dougmany/handplow/img/cutaway.png

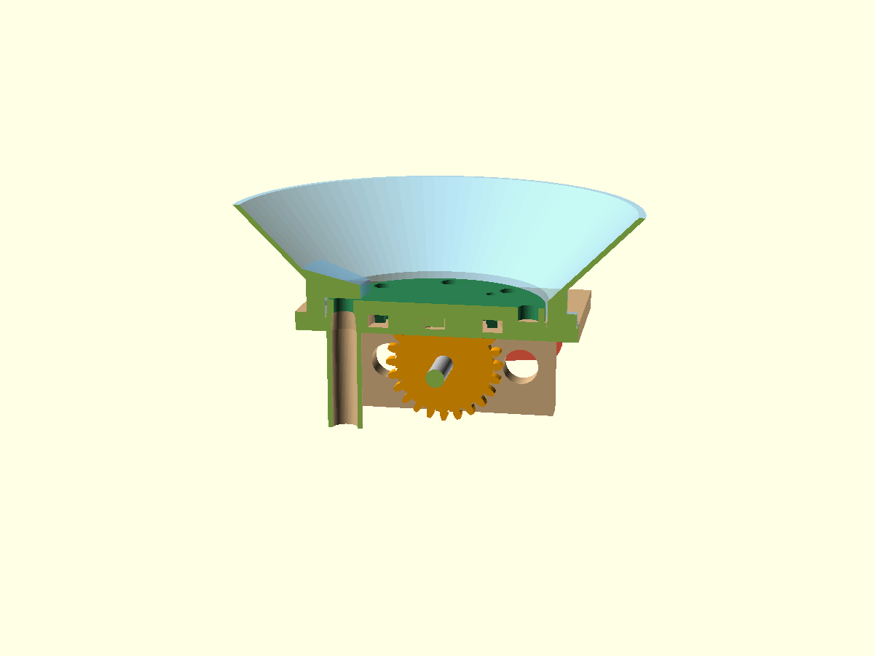
img/cutaway.png
