dougmany/handplow/img/exploded.png

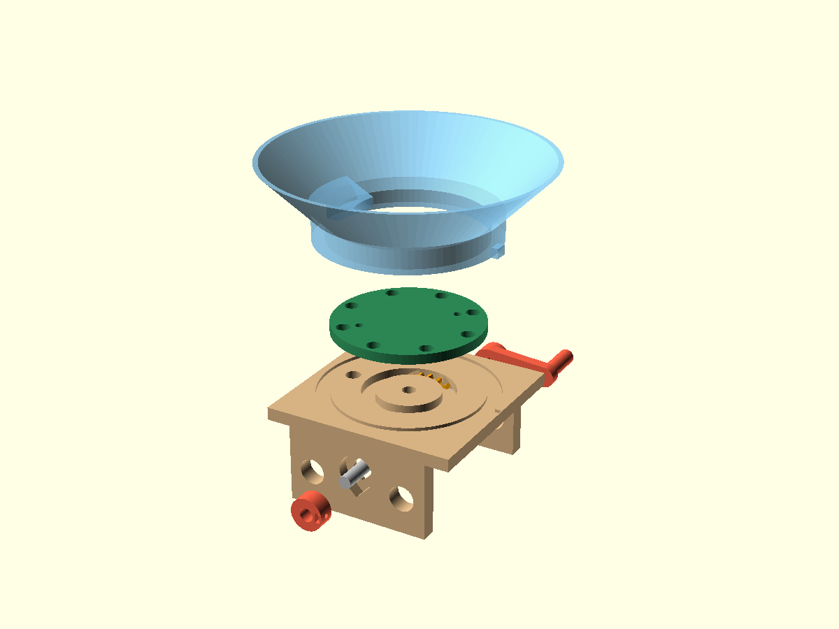
img/exploded.png
