dougmany/handplow/img/plate_underside.png

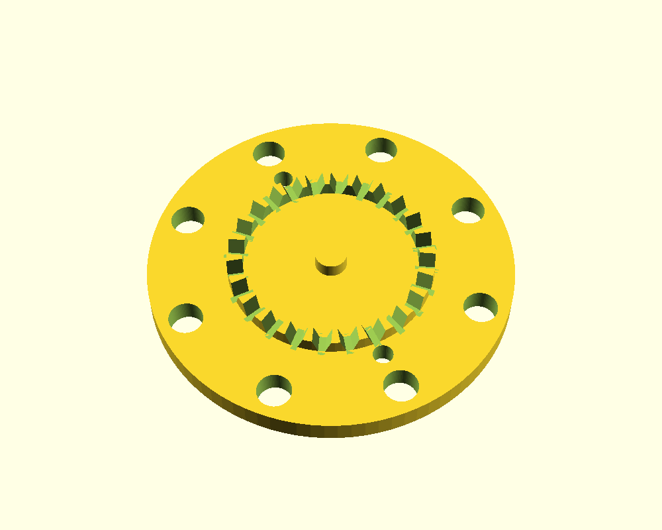
img/plate_underside.png
