dougmany/handplow/img/assembly.png

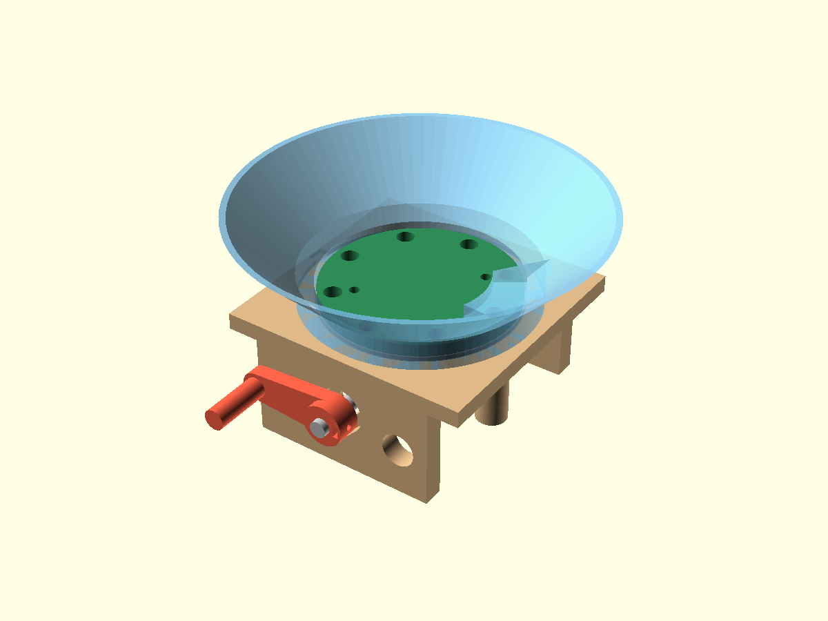
img/assembly.png
